AriyaGup/MREN303---Design-Course---Mobile-robot/Round 5/41EB1040-3B25-4EC6-8802-A79335DE11A0.png

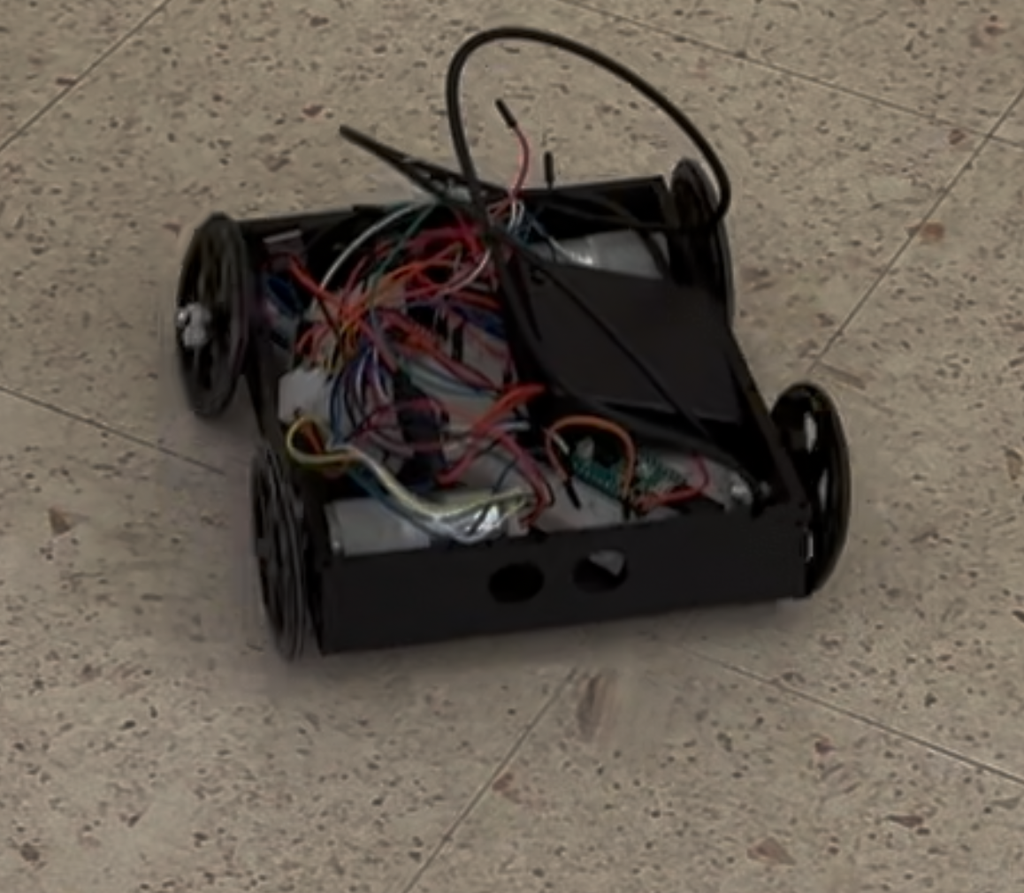
Round 5/41EB1040-3B25-4EC6-8802-A79335DE11A0.png
