AriyaGup/MREN303---Design-Course---Mobile-robot/README.md

# Team Name
Kenstruction Crew

# Members
Ariya Gupta, Samuel Sin 

#Strategy
1. Save Ken
2. Autonomous mode
3. Imprison Dinos
