AriyaGup/MREN303---Design-Course---Mobile-robot/Round 4/README.md

## Round 3 Work Plan Reflection & Module Integration Reflection
Our prototype is designed and mostly ready to be printed, however, we are discussing changing aspects of the design and so are taking our time to print. We are still debating on if we want a front module to gather the dinosaurs, or if that will delay us in completing the competition and just add more weight to the robot. we have so far finalized the barebones structure of the robot - base plate, manipulator, tyres and axle. They work well and fit together, but in an improv print, we added a hook to attach an elastic for added torque when trying to lift props. We need to do more testing with the chassis to make sure battery and electronic components fit well.

We believe the workload is more hardware focused right now and will get more software focused as we integrate modules, so Ariya is contributing to the robot mroe righ tnow and Samuel is organising his code files and discussing on how to approach it to fit the team's needs.

The project is within the specified budget and we have all resources available. Most of the delays are because of the wait times for the 3D printing and laser cutting.

## Design Round 4 Scrum Planning
### Specific goals:
- Remotely drive the robot,
- Have the base of the robot assembled - tyres, axle, gear, chassis
- Organize the wiring.

### Backlog items:
- Laser cut the base plate and L-shaped holds for the axle,
- 3D print the collector,
- PID control.

### Tasks needed to achieve each goal & Who is responsible:
- Update Pico gamepad code to incorporate driving and add code to control manipulator - Samuel
- - Laser cut the base plate and L-shaped holds for the axle - Ariya
- 3D print the collector - Ariya
- Run autonomous mode - Samuel
- Test and refine button-press to end autonomous mode - Ariya, Samuel
- Get encoders to work - Samuel
- Integrate all parts and continue printing and laser cutting where required - Ariya

## Design for Sustainability
The life cycle of a robot is important, and financial and environmental factors must be considered. MREN 303 reusing parts from last year reduces waste and the need to source components every year, which saves emissions caused by transport as well. Careful CAD modeling minimizes reprints, saving material and costs. 

Rechargable batteries are better than disposing a new set of batteries every week that contain rare earth metals. PLA is also buidegradable, so with the right resources, recycling the CAD parts is possible.

## Team Dynamics and Peer Feedback
discussion on peer review

# 
- Updated 3D printing tally
- Uploaded image of current robot prototype
#
## Design review 4 initial thoughts
During this round of testing, our team observed that the robot was able to move back and forth smoothly, demonstrating stable mobility. However, we encountered an issue where one of the prototype’s wheels fell off, indicating a need for a more secure attachment mechanism. This test provided valuable insight into the robot's current functionality and areas that need reinforcement.

For the next iteration, our team plans to test a more complete version of the robot to allow for proper calibration and refinement of its movements. One key improvement will be the addition of differential drive, which is necessary for the robot to move in a confined space such as on top of the ramp, and also implement the gripper.
