AriyaGup/MREN303---Design-Course---Mobile-robot/Round 5/README.md

## Scrum Planning
### What are the specific goals for this round? Aside from meeting this round’s design review deliverables, what are your own goals?
1. Work on Autonomous Mode
2. rework on the gripper CAD to fit the arm
3. Fix wheel axle
4. Fix left turning
5. Code the arm servos

### What are the backlog items from last round?
1. Finish the arm and gripper
2. 3D print a base for the robot for new motor placement for differential drive

### What are the tasks needed to achieve each goal, including the backlog items?
There are no backlog items from last round, however, we are redesigning and reworking some parts of the robot to fit it better with our goals. The tasks can be found in the above sub-sections.

### Who is responsible for each task/goal?
Ariya - CAD and design of the robot. Anything hardware related.
Samuel - Coding each component and wiring.
Both - placement of loose components (breadboard and wire organisation)

## From Workshop 9.2 In 1-2 paragraphs, document your team’s initial thoughts on the mobile robot. What did your team learn from testing it? What do you think worked well? What might your team want to improve upon in the next iteration?
The robot drives in a straight line and has differential drive so it can turn on the spot, however, we are having trouble turning left, so for now we are utilizing right turns to go anywhere on the board. 

We haven't had a chance to code the gripper yet, but the motors are connected to the arm and ready to be screwed onto the top of the chassis. The CAD for the chassis is a perfect fit so we cannot put the top of the chassis on unless we are sure we do not need to open it back up again. The arm length is good but may be a little long since the chassis was fitted to be lower now. 

Most of the remainder tasks are code related and gripper integration with the mobile robot.
