AriyaGup/MREN303---Design-Course---Mobile-robot/Round 3/README.md

## Round 3 Scrum Planning answers
### What are the specific goals for this round? Aside from meeting this round’s design review deliverables, what are your own goals?
Specific goals for this round include a fully integrated electrical circuit, functioning motor control system, and starting on the autonomous mode. We also need to create a power budget.

Our individual goals are to have a fully functional manipulator by the end of this round that reacts to the gamepad commands, along with the base of the robot laser cut. 

## What are the backlog items from last round?
tyre CAD and gearbox

## What are the tasks needed to achieve each goal, including the backlog items?
- Drivetrain CAD
- Wheel CAD
- Autonomous mode completion
- Servo motors working and integrated
- Ultrasonic sensors integrated
- Manipulator CAD 

## Who is responsible for each task/goal?
Documentation, CAD and assembly - Ariya
Component testing, logic and other coding - Samuel

## Mechanical module assembled
We have 3D printed and assembled the manipulator, but are still in the process of attaching the servo safely to the gripper with all its gears and pins in place. Photos of the Manipulator parts can be found in the CAD folder. It was done using Fusion 360. We sketched the robot dimenisons for each part and created it knowing the maximum height the robot will reach once all parts are integrated.

## Electrical schematic and assembly
A photo of both the schematic and the assembly is in the Round 3 folder.
