AriyaGup/MREN303---Design-Course---Mobile-robot/Project Overview.md

Discuss with your team, and document your work plan for the entire project. Your plan should include **SMART goals and objectives, project tasks, task assignments, key deliverables and milestones (course milestones plus your own milestones), required resources and budget, and timelines.** 
This plan should be located outside of Round 1 as it is applicable throughout the course.
---
| Week | Obbjectives | Project Tasks | Task Assigments |
|---|---|---|---|
| 1 | Intro to kit | Examine parts, understand tasks. | All |
| 2 | |Brainstorm ideas, have the Pico W & Gamepad working | All |
| 3 | Round 1 Design Review | Make cardboard prototype of the robot | All |
| 4 | | Motors and Untrasonic sensor testing, FRDPARRC table | All  |
| 5 | Round 2 Design Review | Make CAD files for 3D printing, laser cutting the wood | Ariya – CAD, Samuel – laser cutting |
| 6 | |Assemble base of the robot and have the wheels working and communiccating with the gamepad.| Ariya - assembly, Samuel - software |
| 7 | Round 3 Design Review | Assemble completed robot. | All  |
| 8 | |Complete software for autonomous mode. | Samuel |
| 9 | Round 4 Review | Test and debug autonomous mode, test gripper and trapdoor. | All |
| 10 | |revise design and make code failproof. | All  |
| 11 | Round 5 Design Review + Presentation | Make presentation. | Ariya |
| 12 | Presentation | Present the robot. | All |
| 13 | Final Competition | Compete. | All |

**Autonomous**

- Line Following
- Sensors, Turning, Button-press & Exit
- Exit out of Autonomous Mode

**Manual**

- Gripper CAD
- Robo Body
- Dino catcher with trap-door 
- Motion control of robot using gamepad
- Motion control of arm using gamepad

### Autonomous Mode

**Process:**

Line following sensor to follow the line East to the door. 

Ultrasonic sensor to disable line-follower function and stop a short distance before the door.

Take a sharp left North and go straight to the wall.

Stop a short distance from the wall.

Take a sharp turn East and go forward to press the button. Need to know when to stop after pressing the button.

Go backwards a short distance and either exit the gate diagonally, or turn South and exit forming an arch.

### MANUAL MODE

- Make 3D print of gripper wider for Ken-doll.
- Add glue gun polymer for better grip on props.
- Using gamepad allows for minimal delay and accurate control.

No budget required, since all teams get the same parts. 
An extra motor will need to be accounted for so that the arm can function properly. If not, creating CAD for a mechanism that can use the same servo motor for the vertical pulling of the gripper and turning of the arm will have to be created.

Our goal is to have our robot ready in week 9, with no hardware components left to alter. Any changes made to the robot after Week 9 should be code related.
