AriyaGup/MREN303---Design-Course---Mobile-robot/Health & Safety.md

## Health & Safety 
- Personal 
- Electrical 
- Enviroment 

**Personal Safety**

Eye protection: Goggles should be used during activities like solder or hen using machinery to cut hard objects, fragments may fly into the eyes.

**Training**

Proper training should be required before using dangerous machinery like a laser cutter. We have planned to get training later in the semester for this. Also no one should be alone when work with dangerous machinery. There should be accompanied by a supervisor. 

**Electrical Safety**

Electrical circuit: Double check the wiring and make sure metal part of wires are not exposed before turing any electrical component on to avoid short circuit and electrical shock. Before powering any circuit, at least two team members must verify wiring against the schematic to prevent future miswiring.

Batteries: Monitor batteries condition regularly to avoid using batteries that are damaged, also use the voltage divider to monitor batter level.

Overheating: Check if component are overheating, careful read datasheet before using, make sure components are wired correctly and with the appropriate current and resistance.

**Enviromental Safety**

Fire hazard precaution: Knowing location of fire alarm pull stations, portable fire extinguishers,emergency evacuation procedures

Ventilation: Work in well-ventilated area when soldering or using materials that emit fumes to avoid beathing in harmful gases.

### Round 2 Health and Safety reflection

A key lesson from our early mistakes was the improper wiring of the circuit before the plan was in place, which resulted in a blown fuse. This incident reinforced the importance of having a well-structured health and safety plan.. We considered our experiences from the past 3 weeks and evaluated whether our safety measures were being followed properly. Our team has successfully adhered to the majority of the safety protocols. Based on our experiences, we have made the following adjustments to our plan: Before powering any circuit, both team members must verify wiring against the schematic to prevent future miswiring.
