AriyaGup/MREN303---Design-Course---Mobile-robot/References.md

### References
----
Gripper CAD reference can be found [here](https://www.thingiverse.com/thing:6081735#google_vignette)

Servo Motor CAD reference for adjustments to the above gripper is [here](https://grabcad.com/library/hitec-hs-422-standard-servo-motor-1/details?folder_id=1365155)

MREN 303 Layout taken from the OnQ module
