AriyaGup/MREN303---Design-Course---Mobile-robot/Round 3/Power Budget.md

| Component | Voltage | Current draw (Normal) | Current draw (worse case) | Power | Power (worse case) |
|---|---|---|---|---|---|
| DC x2 | 4.8V | 1A | 4A | 4.8W | 19.2W |
| Servo x3 | 4.8V | 0.75A | 2.1A | 3.6W | 10.08W |
| Line follower x1 | 4.8V | 0.02A | 0.02A | 0.096W | 0.096W |
| Ultrasonic x3 | 4.8V | 0.045A | 0.045A | 0.216W | 0.216W |
| Pico W x1 | 4.8V | 0.1A | 0.3A | 0.48W | 1.44W |
| **Total** | | | | **9.192W** | **31.032W** |

Normal battery life:

2.5Ah/1.915A = 1.305h

Worse case:

2.5Ah/6.465A = 0.387h

References:
MakerPortal.com
Sparkfun.com
Raspberry Pi Forum
