AriyaGup/MREN303---Design-Course---Mobile-robot/Round 2/FRDPARRC Table.md

## Concepts
|Functional Requirements | Design Parameters |Analysis|References|Risk|Countermeasures|
|---|---|---|---|---|---|
|Corral dinosaurs into a catcher on the robot|1. Dump dinosaurs through the top of the cage. 2. Side of the cage.|1. Higher COM,movement of robot will be affected. 2. Lower COM, robot will still stay agile.|Physics and CAD for both|1. Dinosaur is blocked by the cage and falls out. 2. Dinosaurs block the side of the cage as they are put in from the side and not pushed to the otehr end.|1. Make the catcher sturdy to be able to hold the weight of al the dinosaurs and be higher than the minimum clearance height of the cage. 2. Make the Catcher's angle steep so the dinosaurs do not get blocked easily.|
|Individually collecting dinosaurs|1. Grabber mechanism 2. Scoop mechanism|1. Precise control but slower collection 2. Faster collection but less precise.|1. Physics. 2. Actuator specs (Math).|1. We may run out of time. 2. Dinosaur slips or falls down.|1. Add rubberized or textured grips to the gripper for better friction. 2. Make linkage and use a lid to make the dinosaur fall into the scooper.|
|Pushing all dinosaurs to one location|1. Plow or pusher mechanism at the front of the robot. 2. Conveyor belt system.|1. Simple design but may require more force. 2. Efficient but complex and heavier.|1. Physics (force calculations). 2. Motor and belt specs.|1. Dinosaurs may get stuck under the plow. 2. Conveyor belt may jam or malfunction.|1. Ensure the plow has a smooth, angled design to prevent dinosaurs from getting stuck. 2. Use a robust conveyor belt system with regular maintenance checks.|

## Strategy

|Functional Requirements | Design Parameters |Analysis|References|Risk|Countermeasures|
|---|---|---|---|---|---|
|Corral dinosaurs by pushing|Use an excavator snow blade to collect dinosaurs|More efficient and less voltage needed. Can deposit dinosaurs from the side of the cage. |Physics|Dinosaurs might slide to the sides and not get caught in the plow. Would use extra time to collect them. There might also be friction between the gameboard floor and  tbe dinosaurs|Use an angled plow like an excavator wihtout the bottom so dinosaurs do not get caught under the extension.|
|Gripper is at a hinge|The gripper arm would require a motor at elbow joint and a gripper open/close motor|Gripper lifts ken at an angle and doesn't go too high so as to deposit dinosaurs through the side of the cage and Ken is on a floor-level helipad|Physics/measurements of wall so plow can fit through|Cannot get to Ken because of the angle/failed pickup of Ken|use an arm that retracts rather than moves at a fixed hinge.|
