AriyaGup/MREN303---Design-Course---Mobile-robot/Round 2/Health&Safety.md

At the beginning of Round 2, our team carefully reviewed the initial plan, which included specific tasks such as integrating the servo motor, controlling the DC motors using the H-bridge, testing the ultrasonic sensor, designing the gripper in CAD, and preparing components for laser cutting. We also outlined timelines and assigned responsibilities to ensure progress.  Overall, our team is meeting most aspects of the plan. We have successfully connected and tested the servo motor with the Pico W, implemented the H-bridge motor driver to control the DC motors, and assembled the ultrasonic sensor circuit. Additionally, we have created a CAD model of the gripper based on the cardboard prototype. 

We are generally on task, but need to hold each other accountable more often and follow up or update each other with our milestones regularly.

We have not encountered any health and safety risks during our work yet, and with carefully make the rest of the robot adhering to safety rules outlined in our Round 1 deliverable.
