AriyaGup/MREN303---Design-Course---Mobile-robot/Round 1/BackOfTheEnvelopeCalculations.jpg

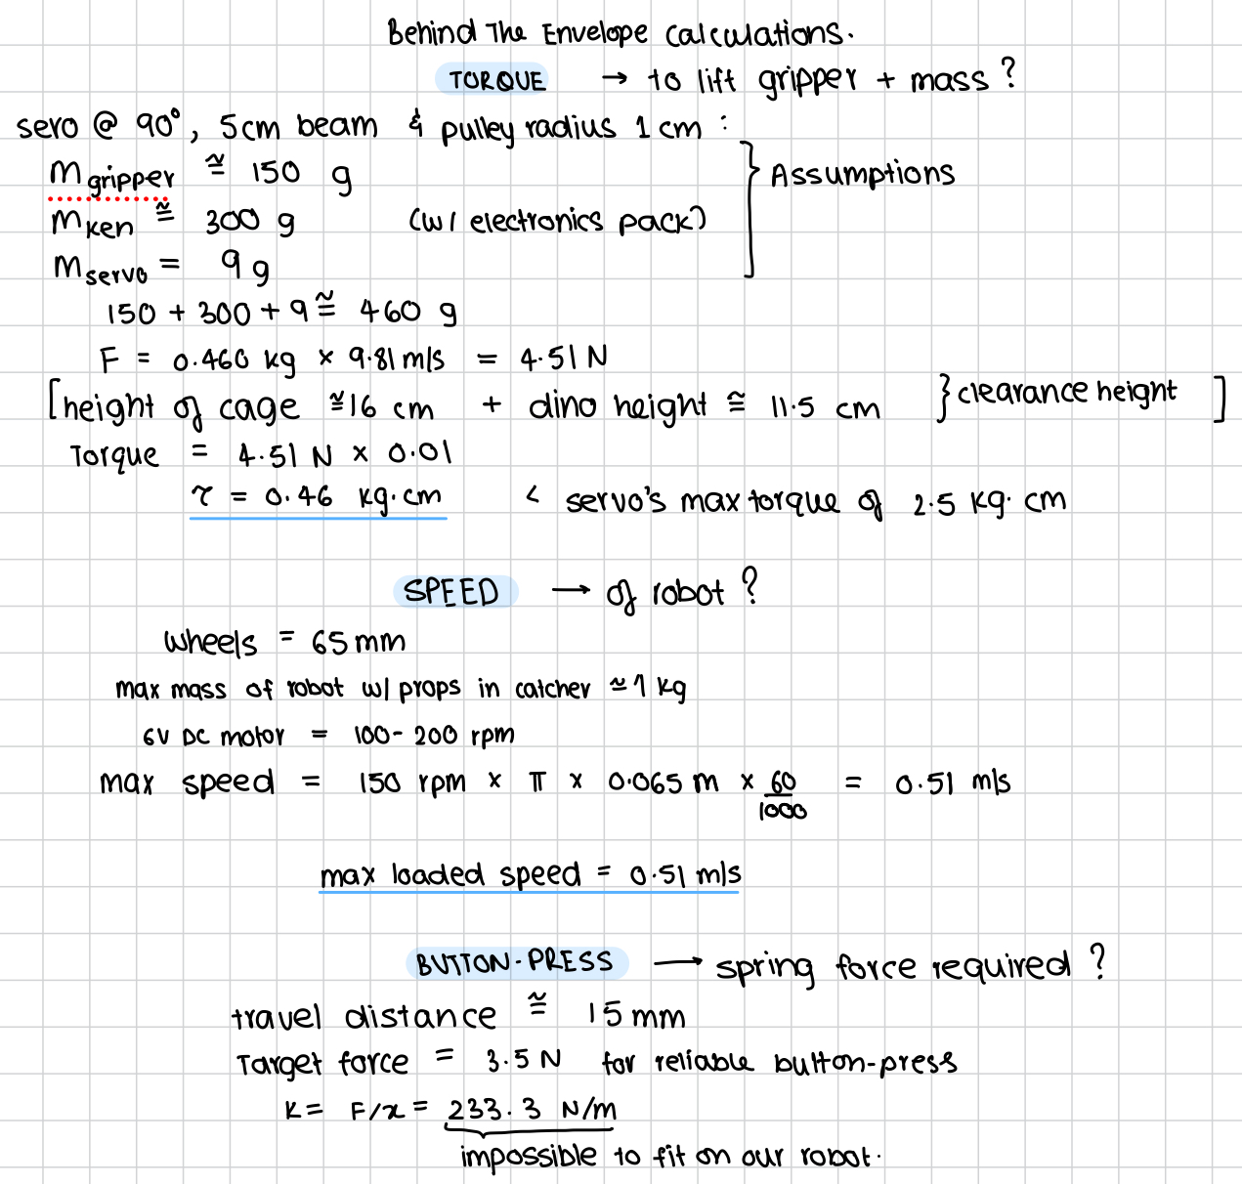
Round 1/BackOfTheEnvelopeCalculations.jpg
