AriyaGup/MREN303---Design-Course---Mobile-robot/Round 1/Ideas.jpg

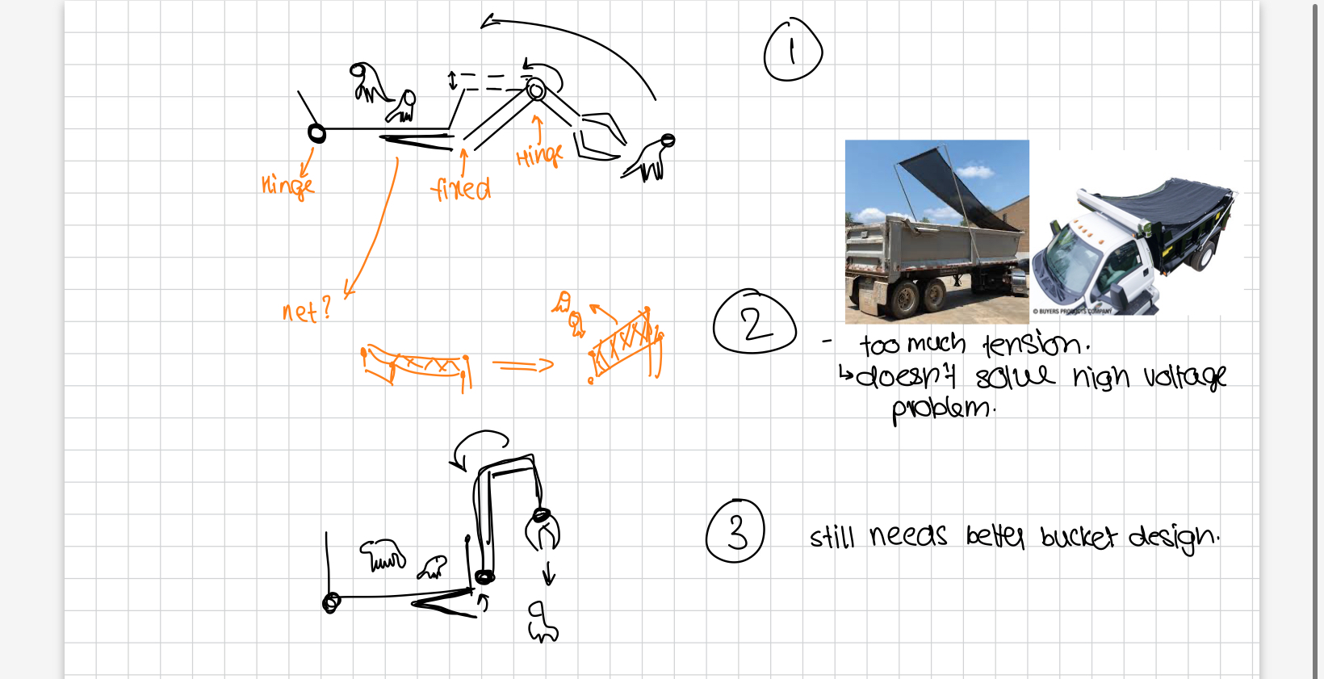
Round 1/Ideas.jpg
