AriyaGup/MREN303---Design-Course---Mobile-robot/Round 2/Ultrasound_R_2_Graph.png

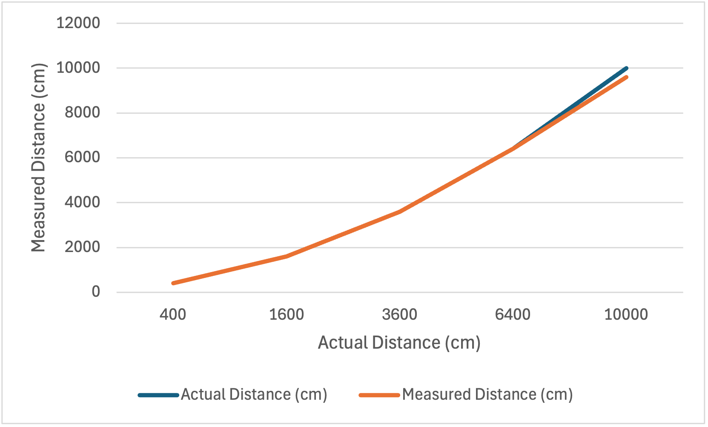
Round 2/Ultrasound_R_2_Graph.png
