AriyaGup/MREN303---Design-Course---Mobile-robot/Round 2/UltrasoundGraph.png

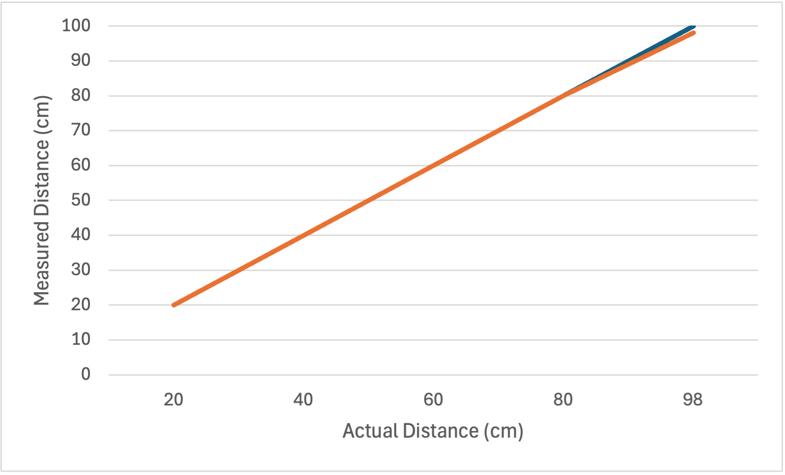
Round 2/UltrasoundGraph.png
