AriyaGup/MREN303---Design-Course---Mobile-robot/Round 3/electrical_schematic.jpg

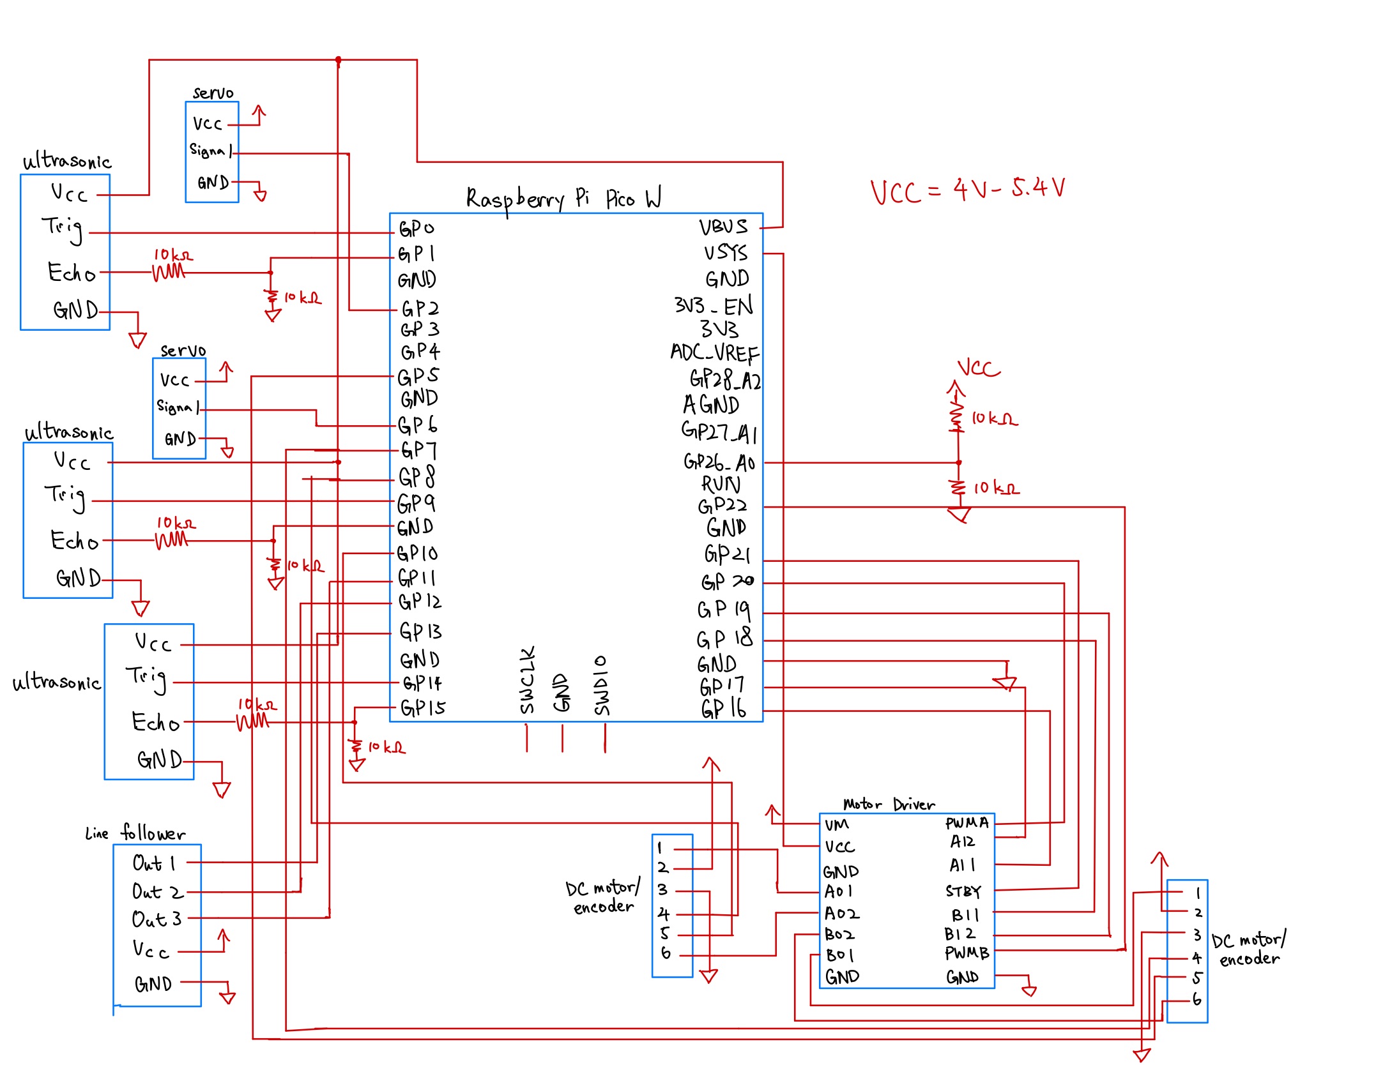
Round 3/electrical_schematic.jpg
