AriyaGup/MREN303---Design-Course---Mobile-robot/Round 5/Screenshot_2025-03-24_at_17.10.06.png

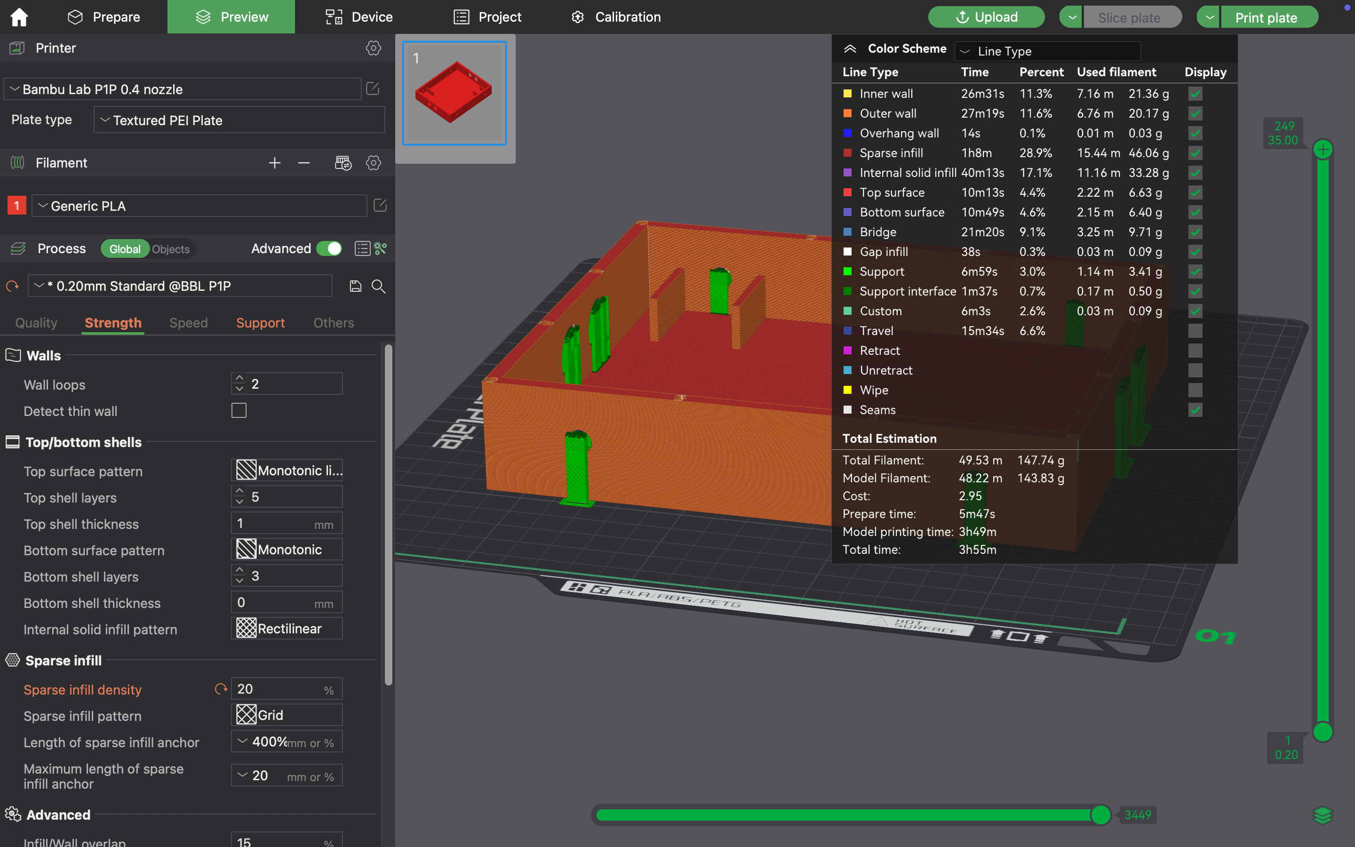
Round 5/Screenshot_2025-03-24_at_17.10.06.png
