AriyaGup/MREN303---Design-Course---Mobile-robot/Round 5/Screenshot_2025-03-24_at_21.57.19.png

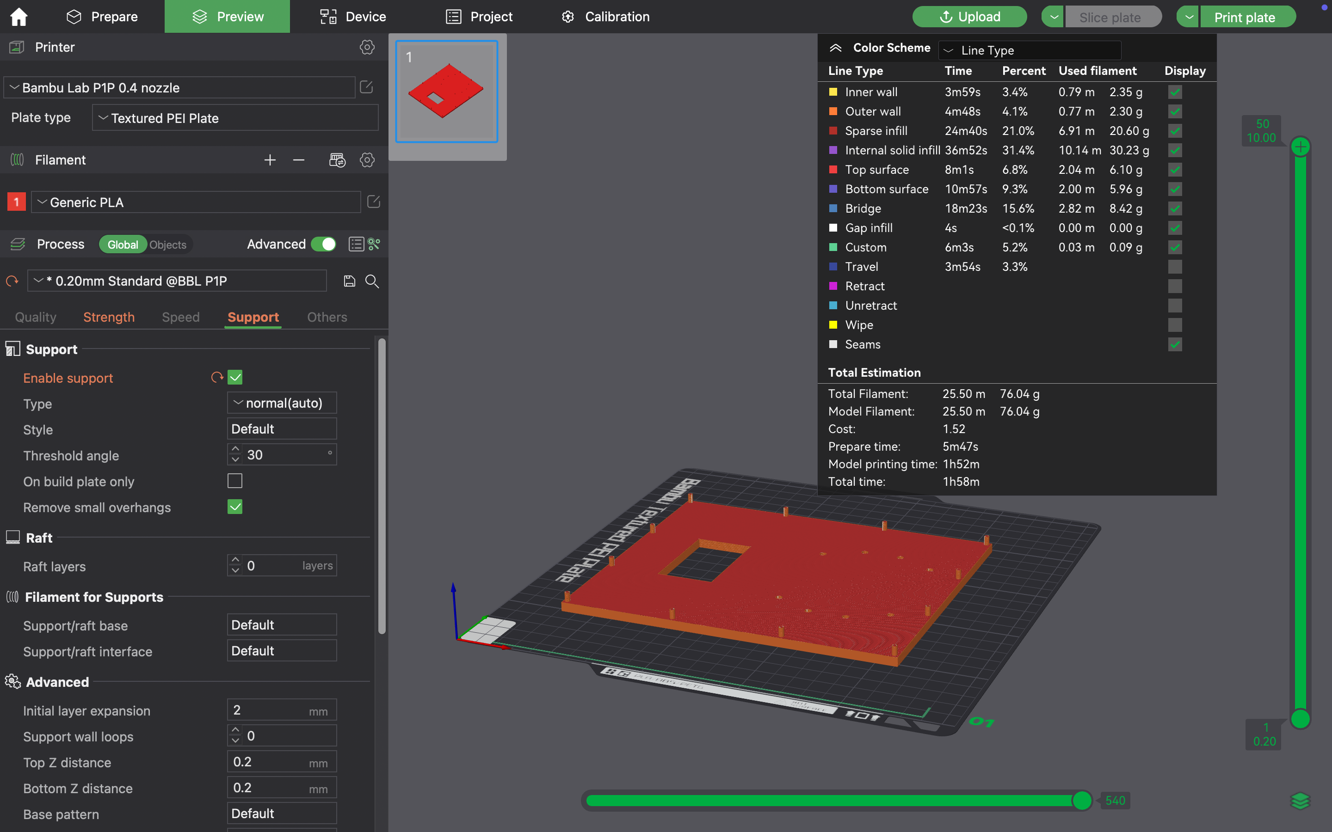
Round 5/Screenshot_2025-03-24_at_21.57.19.png
