AriyaGup/MREN303---Design-Course---Mobile-robot/Round 5/Screenshot_2025-03-24_at_22.09.22.png

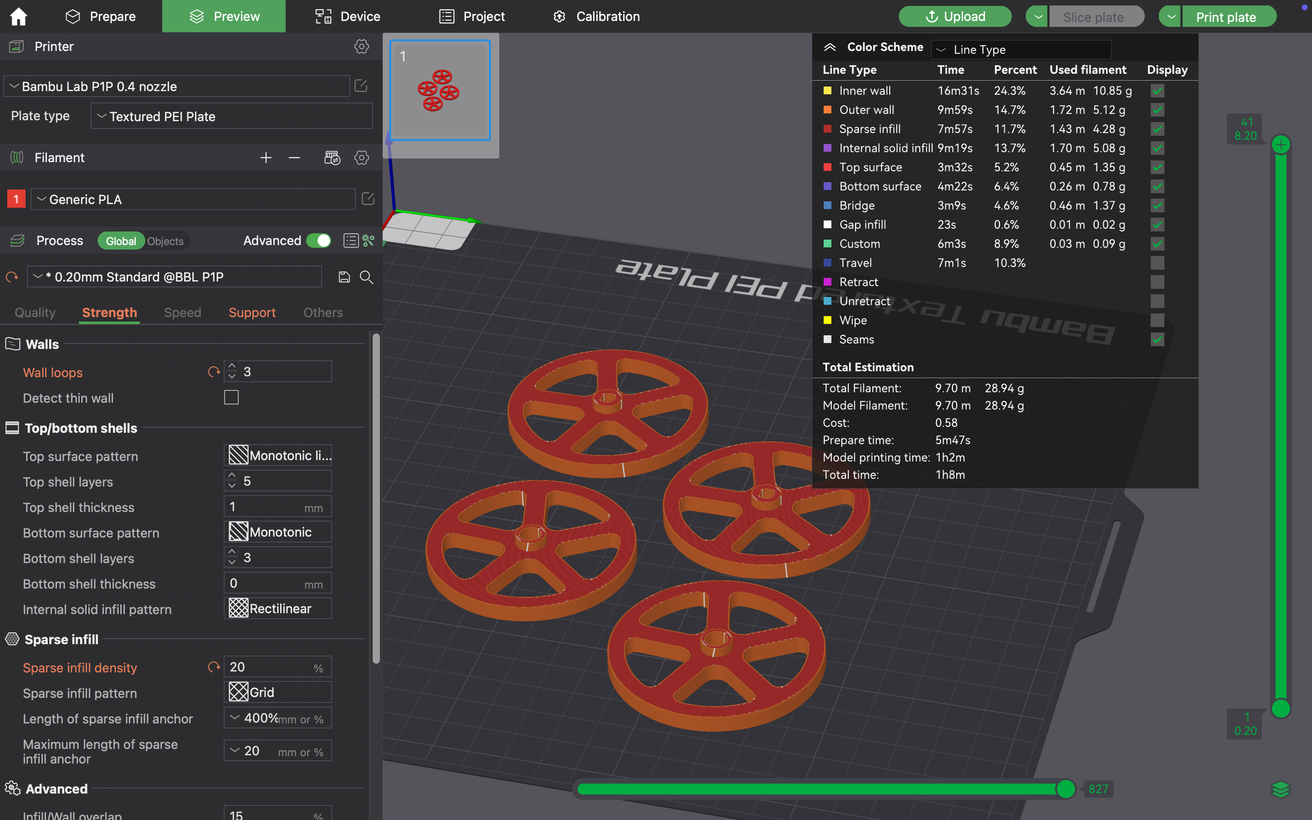
Round 5/Screenshot_2025-03-24_at_22.09.22.png
