AriyaGup/MREN303---Design-Course---Mobile-robot/CAD/303Arm.2_v5.stl

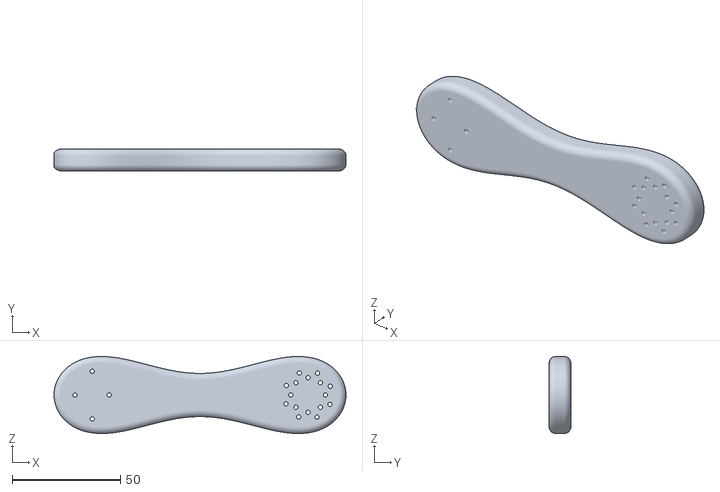
[picture p11: CAD file, 2025-02-27]
CAD/303Arm.2_v5.stl
135.0 x 10.0 x 35.6
