AriyaGup/MREN303---Design-Course---Mobile-robot/CAD/Gripper_v2.stl

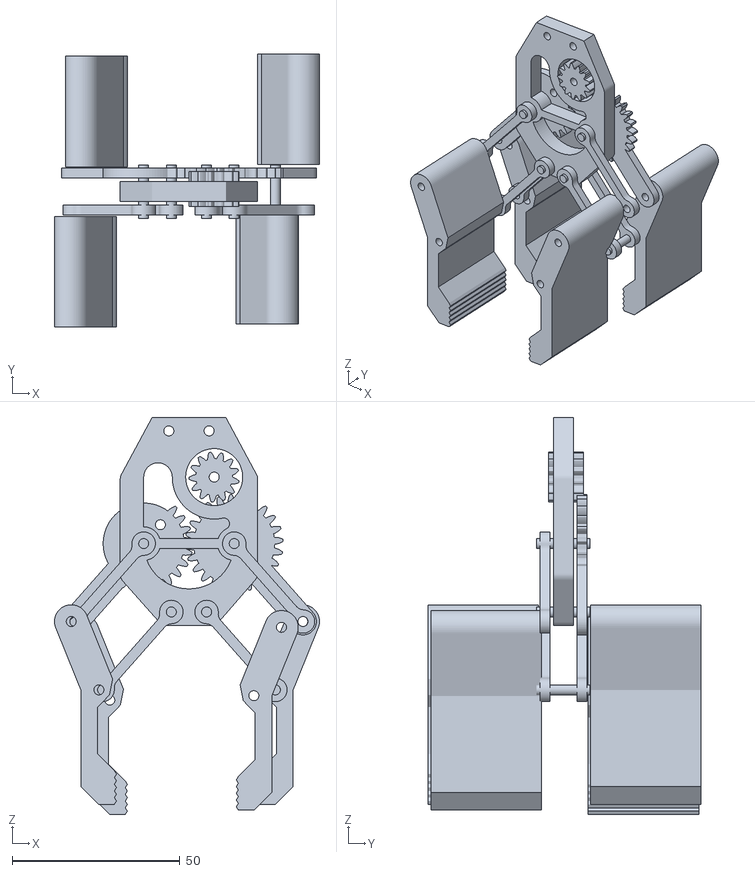
[picture p12: CAD file, 2025-02-27]
CAD/Gripper_v2.stl
79.0 x 81.5 x 118.4
