AriyaGup/MREN303---Design-Course---Mobile-robot/CAD/303Arm_v2.stl

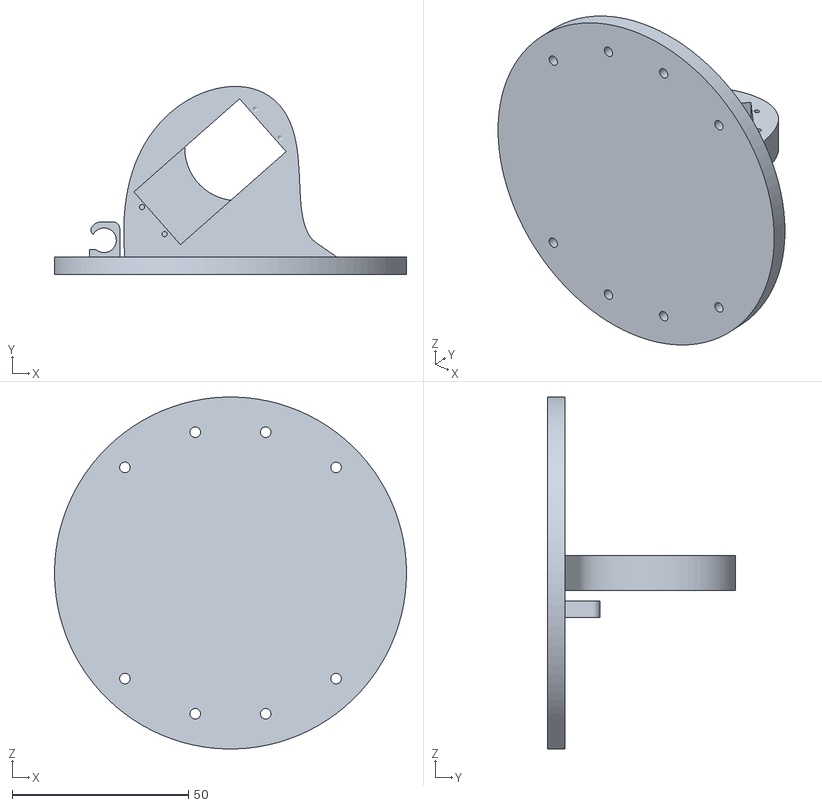
[picture p13: CAD file, 2025-02-27]
CAD/303Arm_v2.stl
100.0 x 53.5 x 100.0
