AriyaGup/MREN303---Design-Course---Mobile-robot/CAD/303Arm.3_v2.stl

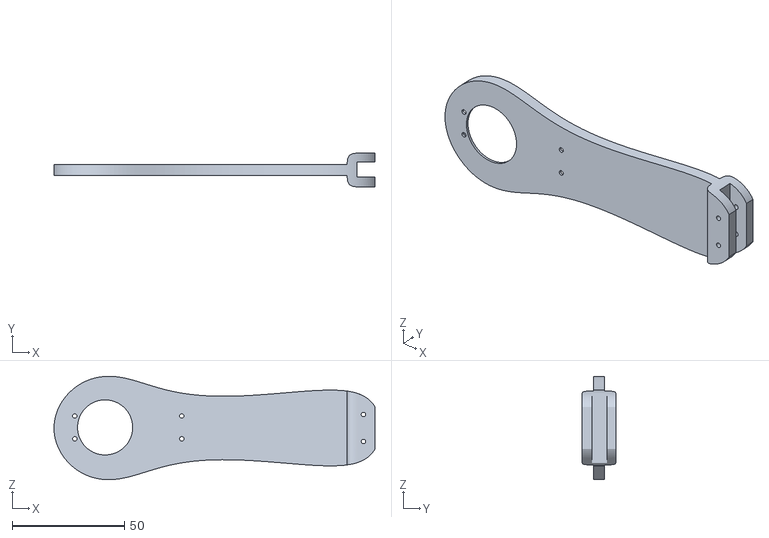
[picture p14: CAD file, 2025-02-27]
CAD/303Arm.3_v2.stl
142.8 x 15.0 x 46.0
