AriyaGup/MREN303---Design-Course---Mobile-robot/CAD/Servo Motor.STEP

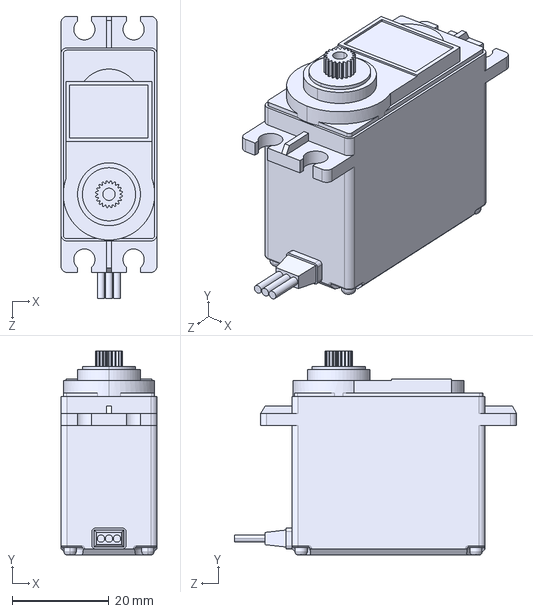
[picture p15: CAD file, 2025-01-23]
CAD/Servo Motor.STEP
19.8 x 42.1 x 58.2 mm
