AriyaGup/MREN303---Design-Course---Mobile-robot/CAD/MREN_303_Field.step

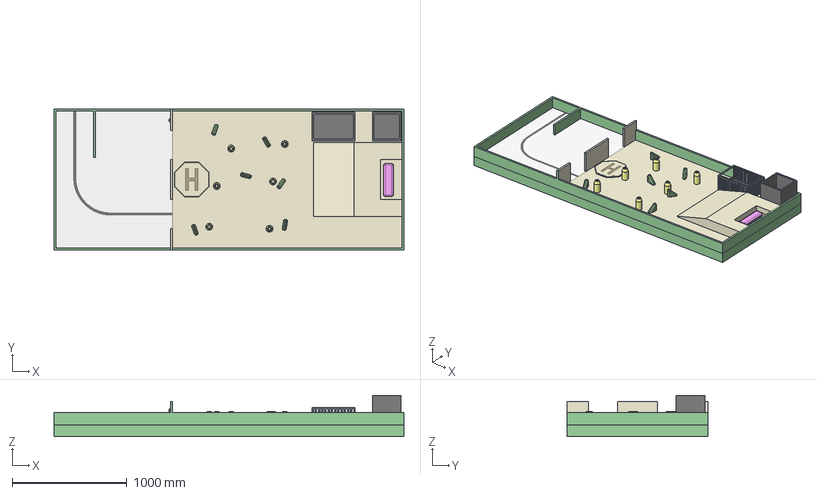
[picture p16: CAD file, 2025-01-22]
CAD/MREN_303_Field.step
3054.0 x 1232.0 x 359.1 mm
Outer Wall (1)
DividerDoor
Helipad
Cage
Ken
Minion1 (1)
Minion2
Minion3
Minion4
Minion5
Minion6
Dino1 (1)
Dino2
Dino3
Dino4
Dino5
Dino6
Floor
Volcano
