AriyaGup/MREN303---Design-Course---Mobile-robot/CAD/Printing&Cutting.md

|Module|Printing Volume|
|---|---|
|Arm base||
|Arm (shoulder to elbow)||
|Arm (elbow to wrist)||
|Gripper||
|Chassis (top & bottom)||
|Tyres||
|**Total**|cm^3|
