AriyaGup/MREN303---Design-Course---Mobile-robot/Round 2/Ultrasound Measurements.md

|Actual Distance (cm)	|Measured Distance (cm)|
|---|---|
|20	|20|
|40	|40|
|60	|60|
|80|80|
|100|98|

y=0.99x

R^2= 0.9801

The measure distances is very accurate. As shown in the table above, before the distance exceeds 80 cm the measured distances is the same as the actual distances. In our plan for the competition we would use the sensor in the Autonomous Mode, we don't need to ditect objects further than 80 cm. Therefore, no adjustments are need for the arduino script. Within the range 2 cm to 400 cm the ultrasonic sensor would only have error less than 1%.
