AriyaGup/MREN303---Design-Course---Mobile-robot/(commit log)

2025-01-21 For CAD files or image rendering
2025-01-21 Upload New File
    [GripperRev1.stl]
2025-02-24 Update Power Budget.md
