AriyaGup/MREN303---Design-Course---Mobile-robot/Round 1/Cardboard_prototype.jpeg

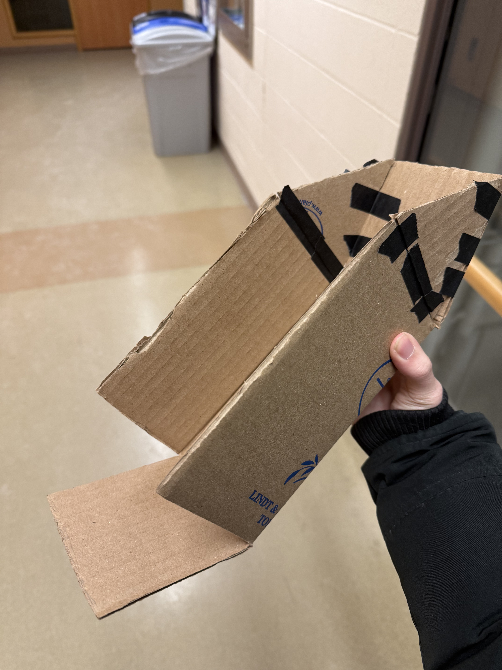
Round 1/Cardboard_prototype.jpeg
